KUBIX2026/Display-Driver/entregas/entrega_02/Readme.md

Place Holder

https://github.com/user-attachments/assets/d8fc2d20-fe5b-433f-9695-f851b03cf18d

https://github.com/user-attachments/assets/b9f2526c-b5e0-483a-a783-c8cad0265786
