KUBIX2026/Display-Driver/entregas/entrega_01/02 - Diagrama de flujo.md

# Diagrama de Flujo del Display Driver

El siguiente diagrama describe el flujo de la pantalla desde su encendido, pasando por la gestión del menú, hasta el bucle de renderizado en tiempo real donde se realiza la multiplexación entre fondos y sprites.
Diagrama de flujo

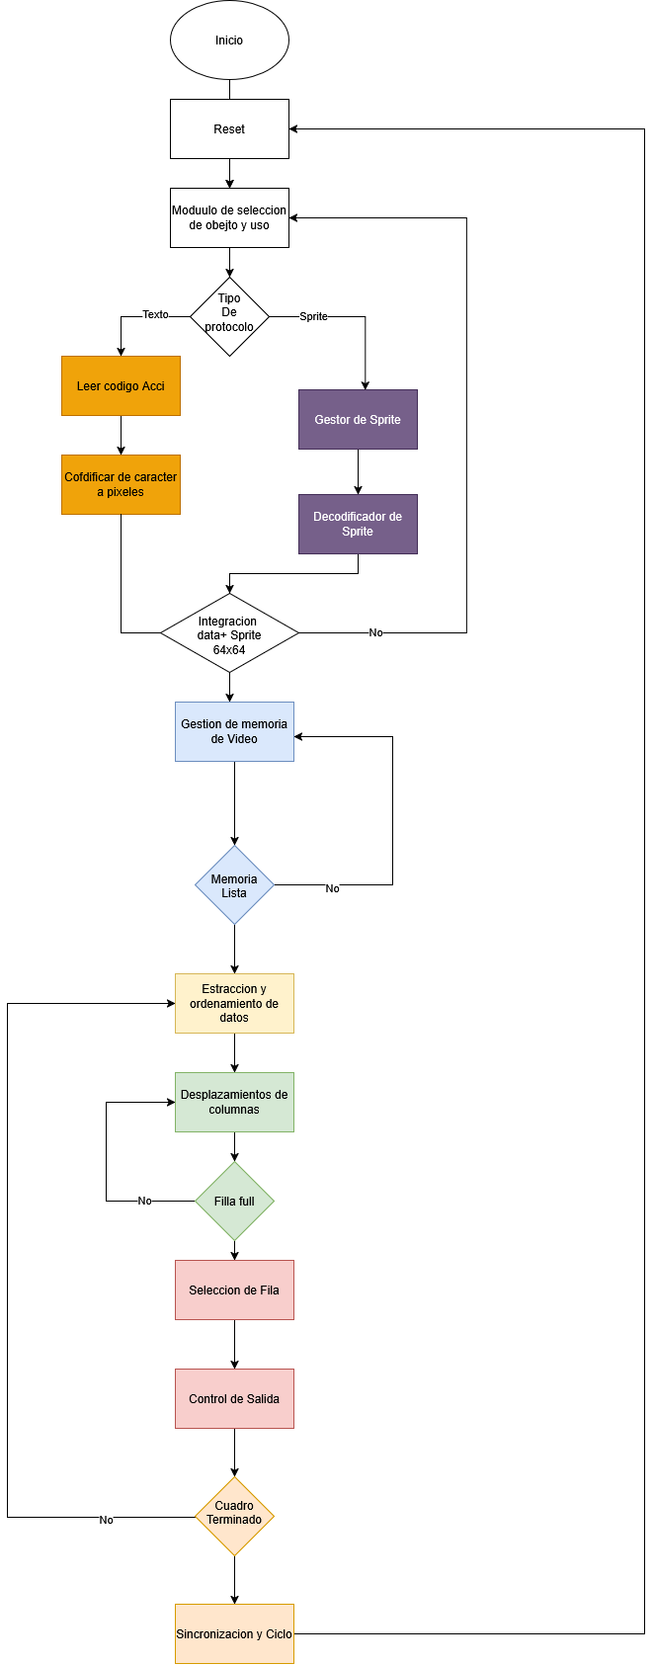
[picture p1: entregas/imgs/Diagrama_con-caracter.png]
Diagrama con texto y sprite


El siguiente diagrama muestra la arquitectura del módulo `top` y la interconexión entre la recepción SPI, la VRAM y el control del panel HUB75.

Diagrama de bloques
