KUBIX2026/Display-Driver/entregas/entrega_01/06 - Seguimiento del Display Driver.md

# Seguimiento del Display Driver

## Estado de las tareas

| ID | Tarea | Responsable | Estado |
|---|---|---|---|
| T01 | Especificación (tramas, registros, errores) | Felipe Diaz | Hecho, sujeto a cambios |
| T02 | Diagramas | Felipe Diaz | Hecho, sujeto a cambios|
| T03 | Verificación modulos de barrido del panel HUB75 y PWM | Felipe Diaz | Hecho |
| T04 | Receptor SPI | Felipe Diaz | Hecho |
| T05 | Decodificador de órdenes | Felipe Diaz | Hecho, sujeto a cambios |
| T06 | Prueba con la ESP32 | Felipe Diaz | Hecho |
| T07 | Compositor (sprites sobre fondo) | Felipe Diaz | En diseño |
| T09 | Memorias de sprites y fondos | Felipe Diaz | En diseño |
| T09 | Doble buffer | Sin definir | Por hacer |
| T10 | Plan de pruebas | Sin definir | En diseño |
