KUBIX2026/Display-Driver/entregas/entrega_01/SPI Decoder and VRAM Flow-2026-10-13-040230.png

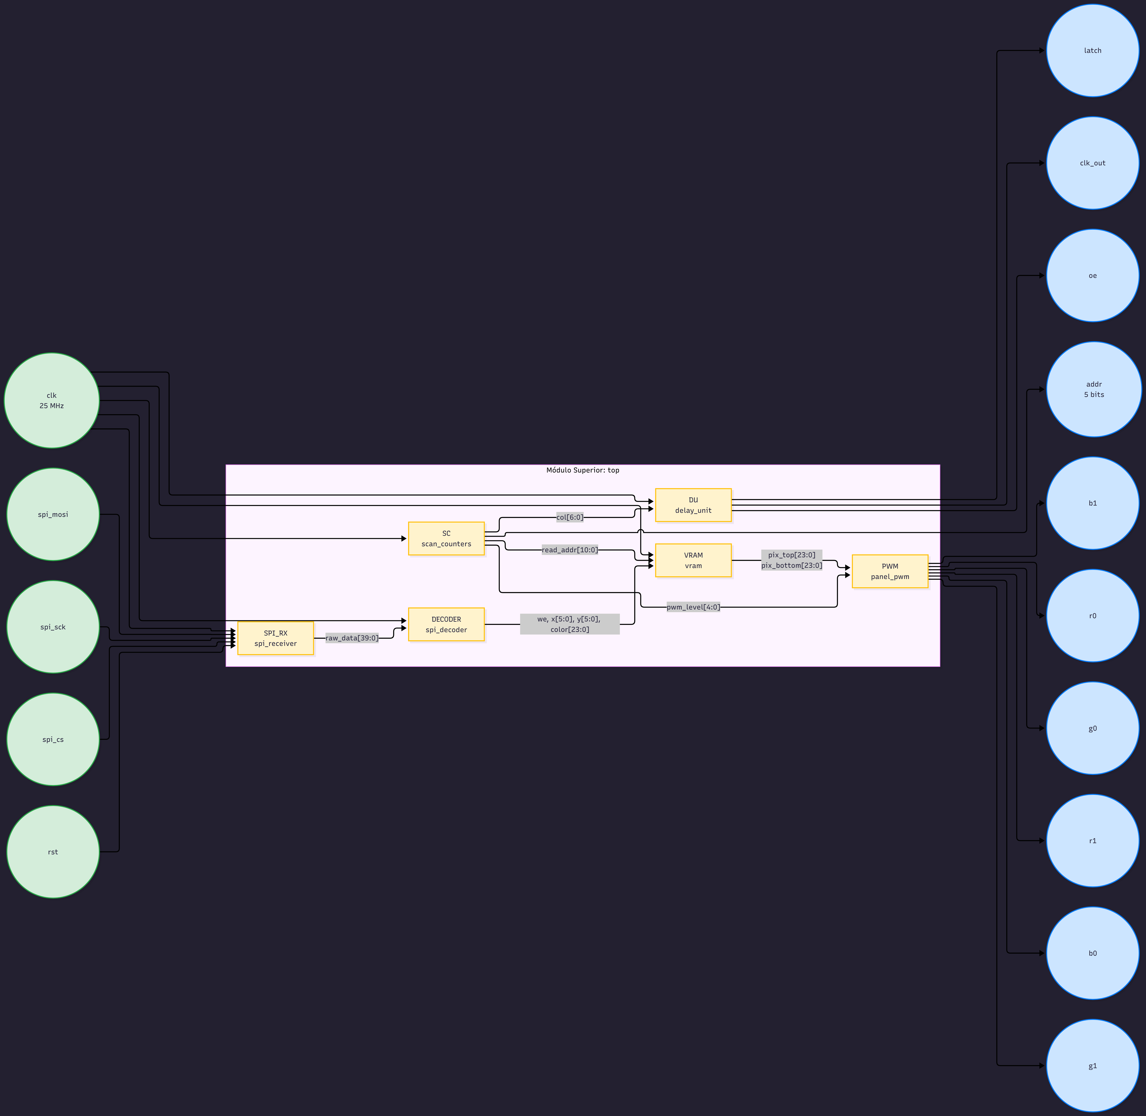
entregas/entrega_01/SPI Decoder and VRAM Flow-2026-10-13-040230.png
