KUBIX2026/Display-Driver/entregas/entrega_01/05 - Planes de prueba.md

# Plan de pruebas del Display Driver

**Estado: en construcción.** Esta sección se irá actualizando a medida que se construyan los módulos del sistema. Cada vez que se haga una prueba nueva para comprobar su integridad, se agregará a la tabla con lo que se manda, lo que se espera y si ya se hizo.

| # | Qué comprobamos | Qué mandamos | Qué esperamos | ¿Hecha? |
|---|---|---|---|---|
| (pendiente) | | | | ☐ |

**Aclaraciones**
