KUBIX2026/Display-Driver/(commit log)

2026-10-13 Add README for Display Driver communication protocols
    Document the communication protocols for the Display Driver module, including input and output protocols, design constraints, and integration tests.
2026-10-13 Rename entregas/01 - Display Driver timing controller.md to entregas/entrega_01/01 - Display Driver timing controller.md
2026-10-13 Move Diagrama de flujo to entrega_01 directory
2026-10-13 Fix image path for SPI timing diagram
    Updated image path for SPI timing diagram in documentation.
2026-10-13 Fix image link in Display Driver timing controller
    Updated image path for HUB75 timing suggestion.
2026-10-13 Update image path for flowchart in documentation
2026-10-13 Rename entregas/entrega_01/SPI Decoder and VRAM Flow-2026-10-13-040230.png to entregas/entrega_01/diagramas_flujo_bloques_estados/diagrama de bloques.png
2026-10-13 Rename diagrama de bloques.png to diagrama_bloques.png
2026-10-13 Fix formatting in README for flowchart link
2026-10-13 Revise diagrams in Diagrama de flujo.md
    Updated flowchart and added block diagram for display driver.
2026-10-27 Enhance README with Display Driver explanation
    Added detailed explanation of the Display Driver initialization process and its state management in the README.
2026-10-27 Renumber section 4 to section 5 in README.md
    Updated section numbering and clarified integration tests for ESP32 firmware.
2026-10-29 Create 03 - Especificación del Display Driver.md
2026-10-29 Fix typo in Display Driver specification table
2026-10-29 Update 03 - Especificación del Display Driver.md
2026-10-29 Create 04 diagramas display driver.md
2026-10-29 Rename 04 diagramas display driver.md to 04 - diagramas display driver.md
2026-10-29 Update 04 - diagramas display driver.md
2026-10-29 Update image in game frame sequence section
    Replaced an image in the game frame sequence section with a new one.
2026-10-29 Create 05 - plan de prueba.md
2026-10-29 Rename diagramas display driver.md file
2026-10-29 Rename 05 - plan de prueba.md to 05 - Plan de prueba.md
2026-10-29 Create 06 - Seguimiento del Display Driver.md
2026-10-29 Update and rename 05 - Plan de prueba.md to 05 - Planes de prueba.md
2026-10-29 Update 06 - Seguimiento del Display Driver.md
2026-10-29 Rename README.md to 00 - Protocolos de Comunicación y Control de Pantalla (Display Driver).md
2026-10-29 Update 00 - Protocolos de Comunicación y Control de Pantalla (Display Driver).md
2026-10-29 Correct diagram file reference in Display Driver spec
    Updated the reference to the diagrams file for clarity.
2026-11-03 Add diagram with text and sprite to flowchart
    Added a new diagram with text and sprite to the document.
2026-11-03 Fix image path for sprite diagram in flowchart
2026-11-10 Revise Metodos.md for LED panel driver architecture
    Updated the documentation for the LED panel driver architecture, including rendering hierarchy and hardware sprite generation details.
2026-11-10 Change image path for sprite pixel generator
    Updated image reference for sprite pixel generator schematic.
